ChrisChrisLoLo/banime40/pcb/README.md

The submodules added here are used for this project.

Big thanks to the contributors of these projects, particularly the folks at Keebio.

Breakdown of what each repo is used for.

- keebio-components
 - Used to for schematic symbols, primarily for the ProMicro symbol
- Keebio-parts.pretty
 - Lots of useful miscelaneous footprints. The ProMicro and hybrid diodes are particularly wonderful
- keyswitches.pretty
 - Really nice Keyswitch footprints. I found these particular footprints to be easy to align with the Switch and Plate drawing 
- keyswitch-kicad-library
 - Usefule stabilizer footprints
