ChrisChrisLoLo/banime40/outlines/README.md

Outlines generated by http://builder.swillkb.com/

Note that outlines here are used to create the case and pcb, but are not the final outlines of said case and pcb
