ChrisChrisLoLo/banime40/case/README.md

# Cases
Here you will find the stls and the step files

The step file contains the entire project, and all the parts that come with it

The stl folder contains all of the parts that you will need to make your own case
