ChrisChrisLoLo/banime40/firmware/via/README.md

Use the json file to sideload the format into VIAL.

Currently, `grid_planck_lite.vil` is what I am currently using.
It's a WIP, but I'm hoping that the layout acts as a bridge between the
default Planck layout and a ~36 key layout.
