ChrisChrisLoLo/banime40/docs/images/IMG_20220319_143908.jpg

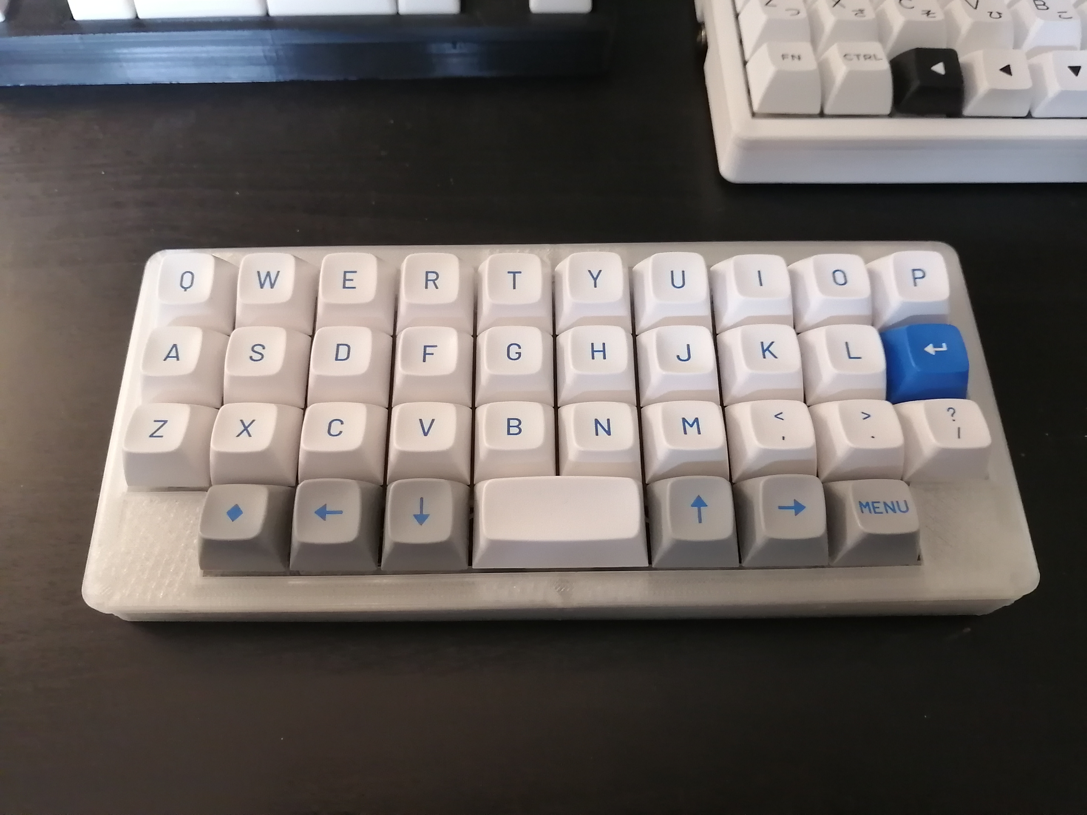
docs/images/IMG_20220319_143908.jpg
