ChrisChrisLoLo/banime40/case/stl/Bottom PCB.stl

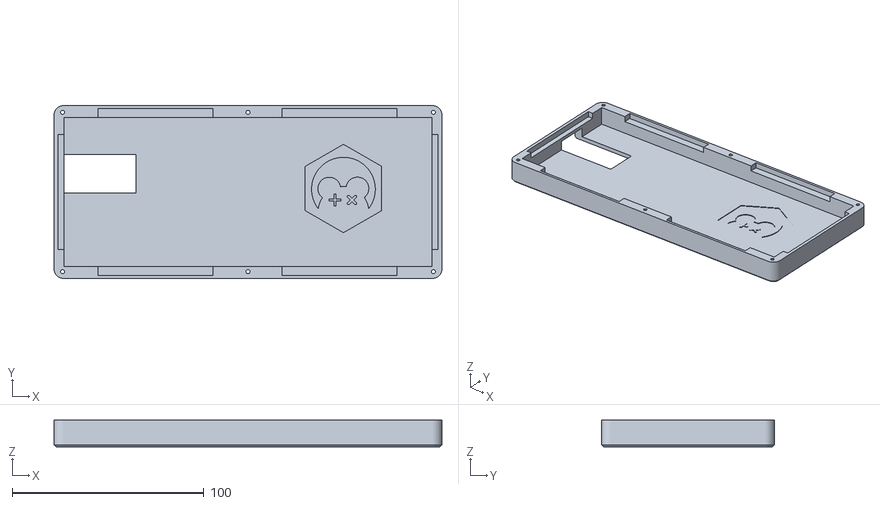
[picture p6: CAD file, 2022-06-25]
case/stl/Bottom PCB.stl
202.5 x 90.2 x 14.0
