ChrisChrisLoLo/banime40/outlines/case/bottom.dxf

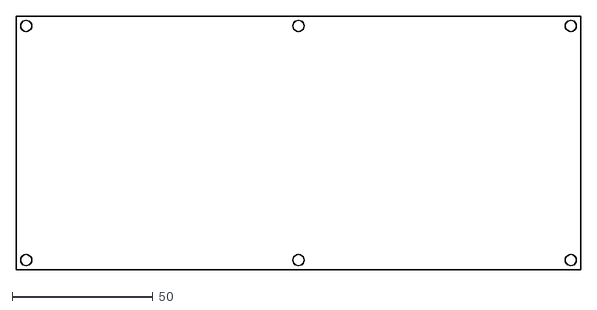
[picture p7: CAD file, 2022-02-22]
outlines/case/bottom.dxf
200.5 x 90.2
