ChrisChrisLoLo/banime40/outlines/case/tops/top_10u_thumbs.dxf

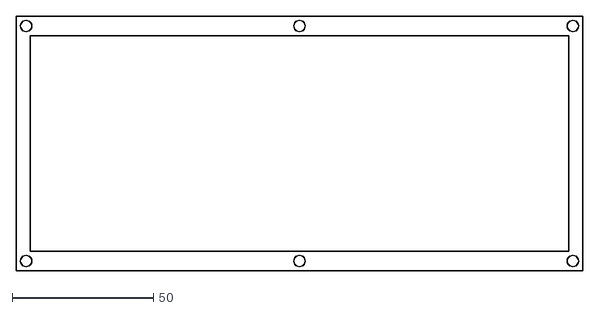
[picture p8: CAD file, 2022-02-22]
outlines/case/tops/top_10u_thumbs.dxf
200.5 x 90.2
