ChrisChrisLoLo/banime40/outlines/pcb/switch_big_spacebar.dxf

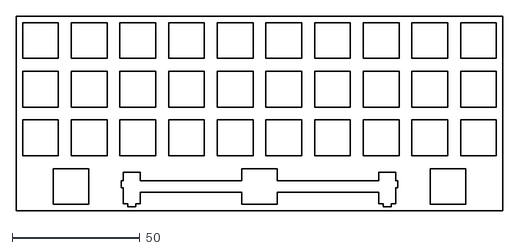
[picture p9: CAD file, 2022-03-01]
outlines/pcb/switch_big_spacebar.dxf
190.5 x 76.2
