ChrisChrisLoLo/banime40/case/stl/Top Grid.stl

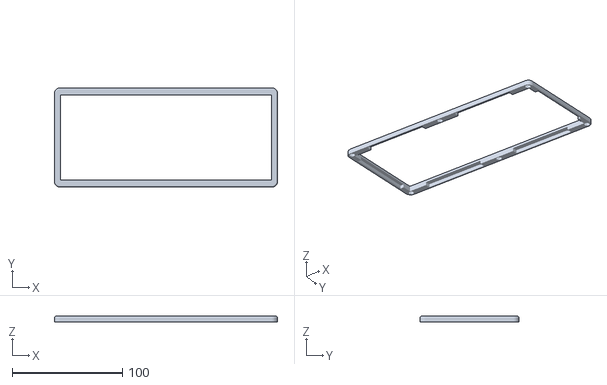
[picture p10: CAD file, 2022-03-20]
case/stl/Top Grid.stl
202.5 x 90.2 x 5.00
