ChrisChrisLoLo/banime40/outlines/case/closed.dxf

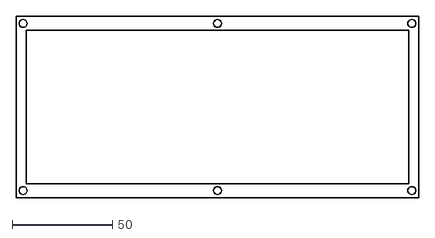
[picture p11: CAD file, 2022-02-22]
outlines/case/closed.dxf
200.5 x 90.2
