ChrisChrisLoLo/banime40/case/stl/Top WKL 6u.stl

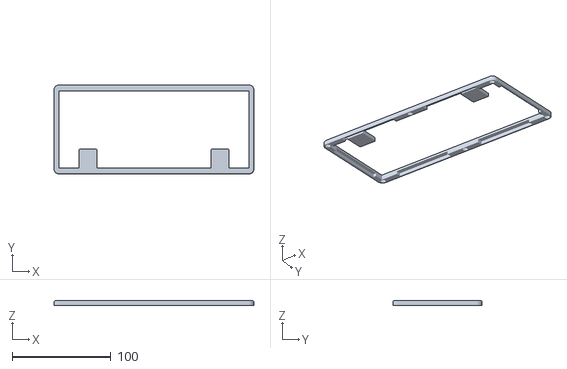
[picture p13: CAD file, 2022-03-20]
case/stl/Top WKL 6u.stl
202.5 x 90.2 x 5.00
