ChrisChrisLoLo/banime40/outlines/case/switch.dxf

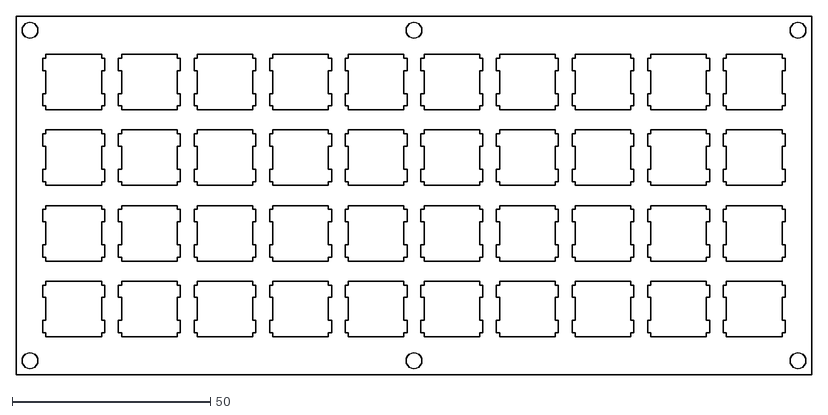
[picture p14: CAD file, 2022-02-22]
outlines/case/switch.dxf
200.5 x 90.2
