ChrisChrisLoLo/banime40/outlines/pcb/switch.dxf

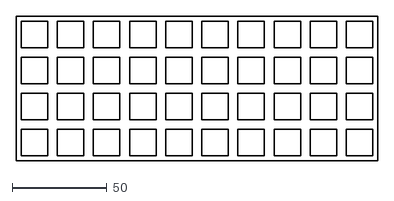
[picture p15: CAD file, 2022-02-22]
outlines/pcb/switch.dxf
190.5 x 76.2
