ChrisChrisLoLo/banime40/case/stl/Top HHKB 6u.stl

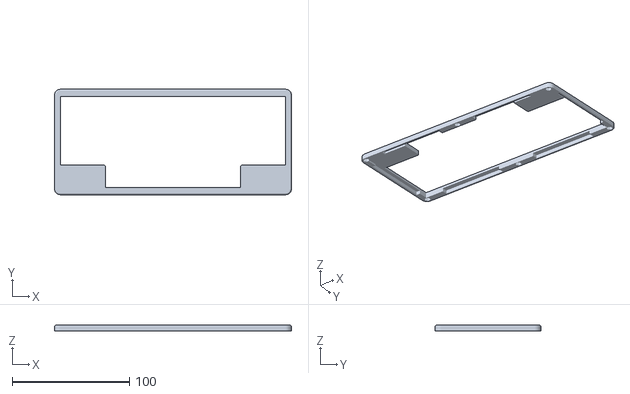
[picture p16: CAD file, 2022-03-20]
case/stl/Top HHKB 6u.stl
202.5 x 90.2 x 5.00
