ChrisChrisLoLo/banime40/case/stl/Plate Final.stl

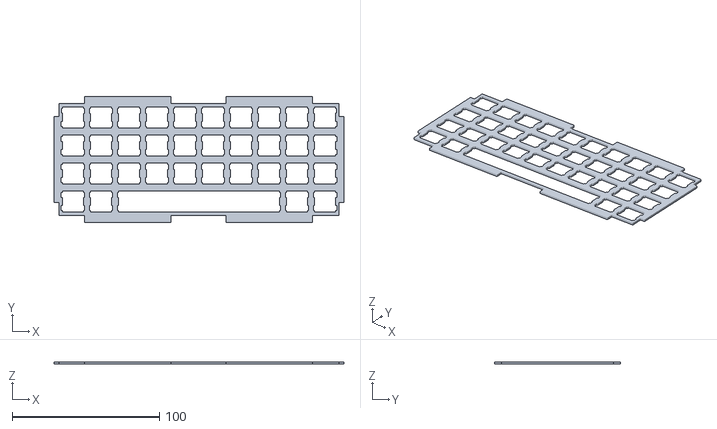
[picture p17: CAD file, 2022-03-20]
case/stl/Plate Final.stl
197.1 x 85.8 x 1.60
