ChrisChrisLoLo/banime40/(list of files, cad)

Other CAD files:
case/stl/Top WKL 6,25u.stl
case/stl/Top HHKB 8u.stl
