ChrisChrisLoLo/banime40/(commit log)

2022-02-22 add outlines
    [bottom.dxf, closed.dxf, switch.dxf, top_10u_thumbs.dxf]
2022-02-22 add kicad files
    [banime40.kicad_pcb, banime40.sch, switch.dxf]
2022-02-22 add pcb
    [banime40.kicad_pcb, banime40.sch]
2022-02-22 make diodes front facing only
    [banime40.kicad_pcb, banime40.sch]
2022-02-27 update pcb (currently incomplete)
    [banime40.kicad_pcb]
2022-02-27 update pcb, add 6 and 6.25 u stab holes
    [banime40.kicad_pcb, banime40.sch]
2022-03-01 update board, add spacebar layout
    [banime40.kicad_pcb, banime40.sch]
2022-03-01 add spacebar outline
    [switch_spacebar.dxf]
2022-03-01 update spacebar layout
    [switch_big_spacebar.dxf]
2022-03-01 Add gerbers
    [banime40-B_Cu.gbl, banime40-B_Mask.gbs, banime40-B_Paste.gbp, banime40-B_SilkS.gbo, banime40-Edge_Cuts.gm1, banime40-F_Cu.gtl, banime40-F_Mask.gts, banime40-F_Paste.gtp]
2022-03-12 add case file
2022-03-20 add case files
    [Bottom PCB.stl, Plate Final.stl, Top Grid.stl, Top HHKB 8u.stl, Top HHKB 6u.stl, Top WKL 6,25u.stl, Top WKL 6u.stl]
2022-04-08 add current VIAL layout
2022-04-14 add version1 of the new keyboard pcb
    [banime40.kicad_pcb, banime40.sch]
2022-04-14 update button placement
    [banime40.kicad_pcb]
2022-04-14 update pcb art
    [banime40.kicad_pcb]
2022-04-14 update text again
    [banime40.kicad_pcb]
2022-04-17 add PCBWay gerbers
    [banime40-B_Cu.gbl, banime40-B_Mask.gbs, banime40-B_Paste.gbp, banime40-B_SilkS.gbo, banime40-Edge_Cuts.gm1, banime40-F_Cu.gtl, banime40-F_Mask.gts, banime40-F_Paste.gtp]
2022-05-10 create v2
    [banime40-B_Cu.gbl, banime40-B_Mask.gbs, banime40-B_Paste.gbp, banime40-B_SilkS.gbo, banime40-B_Silkscreen.gbo, banime40-Edge_Cuts.gm1, banime40-F_Cu.gtl, banime40-F_Mask.gts]
2022-06-25 update PCB text
2022-06-25 increase case screw holes
    [Bottom PCB.stl]
2022-07-19 create patch fix for rotary encoders
    [banime40-B_Cu.gbl, banime40-B_Mask.gbs, banime40-B_Paste.gbp, banime40-B_Silkscreen.gbo, banime40-Edge_Cuts.gm1, banime40-F_Cu.gtl, banime40-F_Mask.gts, banime40-F_Paste.gtp]
2022-07-20 update pcb cosmetic
    [banime40.kicad_pcb]
